widthstudio/car_project/PyBoard_PCB.xls

Comment | Description | Designator | Footprint | LibRef | Quantity
4u7 | Capacitor | C1, C7 | SMD0805 | Cap | 2
2u2 | Capacitor | C2, C13 | SMD0805 | Cap | 2
18p |  | C3, C4 | SMD0603 | Cap | 2
4u7 | Capacitor | C8, C18 | SMD0603 | Cap | 2
2.2p | Capacitor | C9, C10 | SMD0603 | Cap | 2
104 | Capacitor | C11, C12, C14, C15, C16, C17, C19,C5, C6 | SMD0603 | Cap | 7
Diode | Default Diode | D1 | SS24 - small | Diode | 1
LED RED | 红色发光二极管 | D2 | LED0603 | LED-RED | 1
LED GREEN | 绿色发光二极管 | D3 | LED0603 | LED-GREEN | 1
LED Yellow | 黄色发光二极管 | D4 | LED0603 | LED-YELLOW | 1
LED Blue | 蓝色发光二极管 | D5 | LED0603 | LED-BLUE | 1
1uH | Inductor | L1 | SMD0603 | Inductor | 1
3V3X4 | Header, 4-Pin | P1 | HDR1X4 | Header 4 | 1
5VX4 | Header, 4-Pin | P2 | HDR1X4 | Header 4 | 1
GND VIN | Header, 2-Pin | P3 | HDR1X2 | Header 2 | 1
GND TRI ECH SER 5V | Header, 5-Pin | P4 | HDR1X5 | Header 5 | 1
5V GND RX TX | Header, 4-Pin | P5 | HDR1X4 | Header 4 | 1
OUT1 OUT2 | Header, 2-Pin | P6 | HDR1X2 | Header 2 | 1
GNDX4 | Header, 4-Pin | P7 | HDR1X4 | Header 4 | 1
Header 4X2_CARLIGHTS | Header, 4-Pin, Dual row | P8 | HDR2X4 | Header 4X2 | 1
5V XJ1 XJ2 XJ3 XJ4 GND | Header, 6-Pin | P9 | HDR1X6 | Header 6 | 1
BOOT2 | Header, 2-Pin | P10 | HDR1X2 | Header 2 | 1
BOOT1 | Header, 2-Pin | P11 | HDR1X2 | Header 2 | 1
OUT3 OUT4 | Header, 2-Pin | P12 | HDR1X2 | Header 2 | 1
10K | Resistor | R1, R10, R19, R23 | SMD0603 | Res | 4
4K7 | Resistor | R2, R3, R7, R9, R11,R12,R13,R14 | SMD0603 | Res | 8
560 | Resistor | R4, R8, R20, R21, R22, R24 | SMD0603 | Res | 6
22 | Resistor | R5, R6 | SMD0603 | Res | 2
50 | Resistor | R15, R18, R16, R17 | SMD0603 | Res | 4
SW-PB | Switch | RST | SW 3X6 | SW-PB | 1
STM32F405RGT6 | ARM Cortex-M4 32-bit MCU+FPU, 210 DMIPS, 1024 kB Flash, 192 kB Internal RAM, 51 I/Os, 64-pin LQFP, -40 to 85 degC, Tray | U1 | LQFP64_M | STM32F405RGT6 | 1
XC6206 |  | U2 | SOT-23_N | XC6206 | 1
MicroUSB |  | U3 | MicroUSB | MicroUSB | 1
L298N | Dual Full Bridge Driver | U4 | Multiwatt15V | L298N | 1
USER | Switch | USR | SW 3X6 | SW-PB | 1
8M | SMD5032 8M 4Pin有源晶振 | Y1 | SMD5032 | XTAL_SMD | 1
32K | Crystal Oscillator | Y2 | TXC_9H03200019 | XTAL | 1
电池盒子
