widthstudio/car_project/project_doc/报销表格.xlsx

姓名 | 班级 | 题目 | 费用类别（器件、模块、制板或其他） | 型号 | 单价 | 个数 | 总价 | 剩余个数 | 购买链接（网上购买的需填写）
李荆晖 | 工企 | 基于Micropython的多功能小车 | 模块 | LD3320 | 76 | 1 | 76 | 0 | https://item.taobao.com/item.htm?id=525259762949&ns=1&abbucket=4 (https://item.taobao.com/item.htm?spm=a230r.1.14.83.1fda7ccdjaIbIS&id=525259762949&ns=1&abbucket=4)
陈钱牛 | 工企 | 基于Micropython的多功能小车 | 器件 | L7805ABV | 1.41 | 2 | 2.82 | 0 | https://detail.tmall.com/item.htm?id=43264897196&spm=a1z09.2.0.0.67002e8dljWcKT&_u=q2mm4h814183
陈钱牛 | 工企 | 基于Micropython的多功能小车 | 器件 | 5032 8M无源晶振 | 0.5 | 8 | 4 | 2 | https://item.taobao.com/item.htm?spm=a1z09.2.0.0.67002e8dljWcKT&id=577059124463&_u=q2mm4h8151b2
陈钱牛 | 工企 | 基于Micropython的多功能小车 | 器件 | STM32RGT6 | 18.3 | 6 | 109.8 | 0 | https://item.taobao.com/item.htm?spm=a1z09.2.0.0.67002e8dljWcKT&id=593075165051&_u=q2mm4h816ff9
陈钱牛 | 工企 | 基于Micropython的多功能小车 | 器件 | L298N | 8.08 | 2 | 16.16 | 0 | https://detail.tmall.com/item.htm?id=12993617140&spm=a1z09.2.0.0.67002e8dljWcKT&_u=q2mm4h813b0e
陈钱牛 | 工企 | 基于Micropython的多功能小车 | 器件 | 32K晶振 | 0.57 | 4 | 2.28 | 0 | https://item.taobao.com/item.htm?spm=a1z09.2.0.0.67002e8dljWcKT&id=572487260654&_u=q2mm4h81398c
陈钱牛 | 工企 | 基于Micropython的多功能小车 | 器件 | USB母头 | 0.304 | 10 | 3.04 | 0 | https://detail.tmall.com/item.htm?id=14422856956&spm=a1z09.2.0.0.67002e8dljWcKT&_u=q2mm4h814bf0
陈钱牛 | 工企 | 基于Micropython的多功能小车 | 器件 | 绿色贴片LED | 0.1715 | 20 | 3.43 | 0 | https://detail.tmall.com/item.htm?id=13860351935&spm=a1z09.2.0.0.67002e8dljWcKT&_u=q2mm4h814348
陈钱牛 | 工企 | 基于Micropython的多功能小车 | 器件 | 红色贴片LED | 0.0324 | 50 | 1.62 | 0 | https://detail.tmall.com/item.htm?id=13860351935&spm=a1z09.2.0.0.67002e8dljWcKT&_u=q2mm4h814348
陈钱牛 | 工企 | 基于Micropython的多功能小车 | 器件 | 黄色贴片LED | 0.1735 | 20 | 3.47 | 0 | https://detail.tmall.com/item.htm?id=13860351935&spm=a1z09.2.0.0.67002e8dljWcKT&_u=q2mm4h814348
陈钱牛 | 工企 | 基于Micropython的多功能小车 | 器件 | 蓝色贴片LED | 0.1385 | 20 | 2.77 | 0 | https://detail.tmall.com/item.htm?id=13860351935&spm=a1z09.2.0.0.67002e8dljWcKT&_u=q2mm4h814348
陈钱牛 | 工企 | 基于Micropython的多功能小车 | 器件 | 0603 1uH电感 | 0.058 | 20 | 1.16 | 0 | https://detail.tmall.com/item.htm?id=13673263456&spm=a1z09.2.0.0.67002e8dljWcKT&_u=q2mm4h8105ce
陈钱牛 | 工企 | 基于Micropython的多功能小车 | 器件 | XC6206稳压芯片 | 0.185 | 10 | 1.85 | 0 | https://detail.tmall.com/item.htm?id=14477500122&spm=a1z09.2.0.0.67002e8dljWcKT&_u=q2mm4h8107e8
陈钱牛 | 工企 | 基于Micropython的多功能小车 | 器件 | 开关按钮（绿色无光） | 1.28 | 1 | 1.28 | 0 | https://detail.tmall.com/item.htm?id=585191757505&spm=a1z09.2.0.0.67002e8dljWcKT&_u=q2mm4h818958
陈钱牛 | 工企 | 基于Micropython的多功能小车 | 模块 | HC-SR04 | 6.77 | 2 | 13.54 | 0 | https://detail.tmall.com/item.htm?id=580427945752&spm=a1z09.2.0.0.67002e8dljWcKT&_u=q2mm4h819abf
陈钱牛 | 工企 | 基于Micropython的多功能小车 | 模块 | 码盘计数器 | 5.53 | 2 | 11.06 | 2 | https://detail.tmall.com/item.htm?id=564149772805&spm=a1z09.2.0.0.67002e8dljWcKT&_u=q2mm4h81c4b5
陈钱牛 | 工企 | 基于Micropython的多功能小车 | 模块 | LM2596S 稳压器 | 19.06 | 1 | 19.06 | 1 | https://detail.tmall.com/item.htm?id=41307963557&spm=a1z09.2.0.0.67002e8dljWcKT&_u=q2mm4h81f88c
陈钱牛 | 工企 | 基于Micropython的多功能小车 | 模块 | L298N | 5.83 | 2 | 11.66 | 2 | https://item.taobao.com/item.htm?spm=a1z09.2.0.0.67002e8dljWcKT&id=15751837530&_u=q2mm4h819cb8
陈钱牛 | 工企 | 基于Micropython的多功能小车 | 模块 | 红外管模块 | 1.33 | 2 | 2.66 | 2 | https://item.taobao.com/item.htm?spm=a1z09.2.0.0.67002e8dljWcKT&id=581721553384&_u=q2mm4h812bb5
陈钱牛 | 工企 | 基于Micropython的多功能小车 | 模块 | USB转TTL模块 | 8.3 | 1 | 8.3 | 1 | https://detail.tmall.com/item.htm?id=26521552017&spm=a1z09.2.0.0.67002e8dljWcKT&_u=q2mm4h813421
陈钱牛 | 工企 | 基于Micropython的多功能小车 | 模块 | HC06蓝牙模块 | 21 | 1 | 21 | 0 | https://item.taobao.com/item.htm?spm=a1z09.2.0.0.67002e8dljWcKT&id=543489102902&_u=q2mm4h81cb55
陈钱牛 | 工企 | 基于Micropython的多功能小车 | 模块 | HC02蓝牙模块 | 17.8 | 1 | 17.8 | 0 | https://item.taobao.com/item.htm?spm=a1z09.2.0.0.67002e8dljWcKT&id=543489102902&_u=q2mm4h81cb56
陈钱牛 | 工企 | 基于Micropython的多功能小车 | 其他 | 舵机云台 | 18.8 | 1 | 18.8 | 0 | https://detail.tmall.com/item.htm?id=567021295563&spm=a1z09.2.0.0.67002e8dljWcKT&_u=q2mm4h81fd46
陈钱牛 | 工企 | 基于Micropython的多功能小车 | 其他 | 大容量8.4V锂电池 | 42 | 1 | 42 | 0 | https://item.taobao.com/item.htm?spm=a1z09.2.0.0.67002e8dljWcKT&id=531990145742&_u=q2mm4h81090e
陈钱牛 | 工企 | 基于Micropython的多功能小车 | 其他 | 锂电池充电器 | 10.8 | 1 | 10.8 | 1 | https://item.taobao.com/item.htm?spm=a1z09.2.0.0.67002e8dljWcKT&id=546489778669&_u=q2mm4h81f00a
陈钱牛 | 工企 | 基于Micropython的多功能小车 | 其他 | 锂电池充电转接头 | 1.5 | 1 | 1.5 | 1 | https://item.taobao.com/item.htm?spm=a1z09.2.0.0.67002e8dljWcKT&id=568056529789&_u=q2mm4h81222e
陈钱牛 | 工企 | 基于Micropython的多功能小车 | 其他 | 小车底盘 | 29.68 | 1 | 29.68 | 0 | https://item.taobao.com/item.htm?spm=a1z09.2.0.0.67002e8dljWcKT&id=41398682326&_u=q2mm4h81c2e1
陈钱牛 | 工企 | 基于Micropython的多功能小车 | 其他 | 40P公对公连接线 | 2.6 | 1 | 2.6 | 0 | https://item.taobao.com/item.htm?spm=a1z09.2.0.0.67002e8dljWcKT&id=544521868669&_u=q2mm4h81927d
陈钱牛 | 工企 | 基于Micropython的多功能小车 | 其他 | 面包板 | 4.5 | 1 | 4.5 | 1 | https://item.taobao.com/item.htm?spm=a1z09.2.0.0.67002e8dljWcKT&id=543472797890&_u=q2mm4h81b7f7
陈钱牛 | 工企 | 基于Micropython的多功能小车 | 其他 | 电池盒子 | 1.62 | 1 | 1.62 | 1 | https://item.taobao.com/item.htm?spm=a1z09.2.0.0.67002e8dljWcKT&id=543472797890&_u=q2mm4h81b7f7
总计 |  |  |  |  |  |  | 446.26
