widthstudio/car_project/PCB3/PyBoard_PCB.pdf

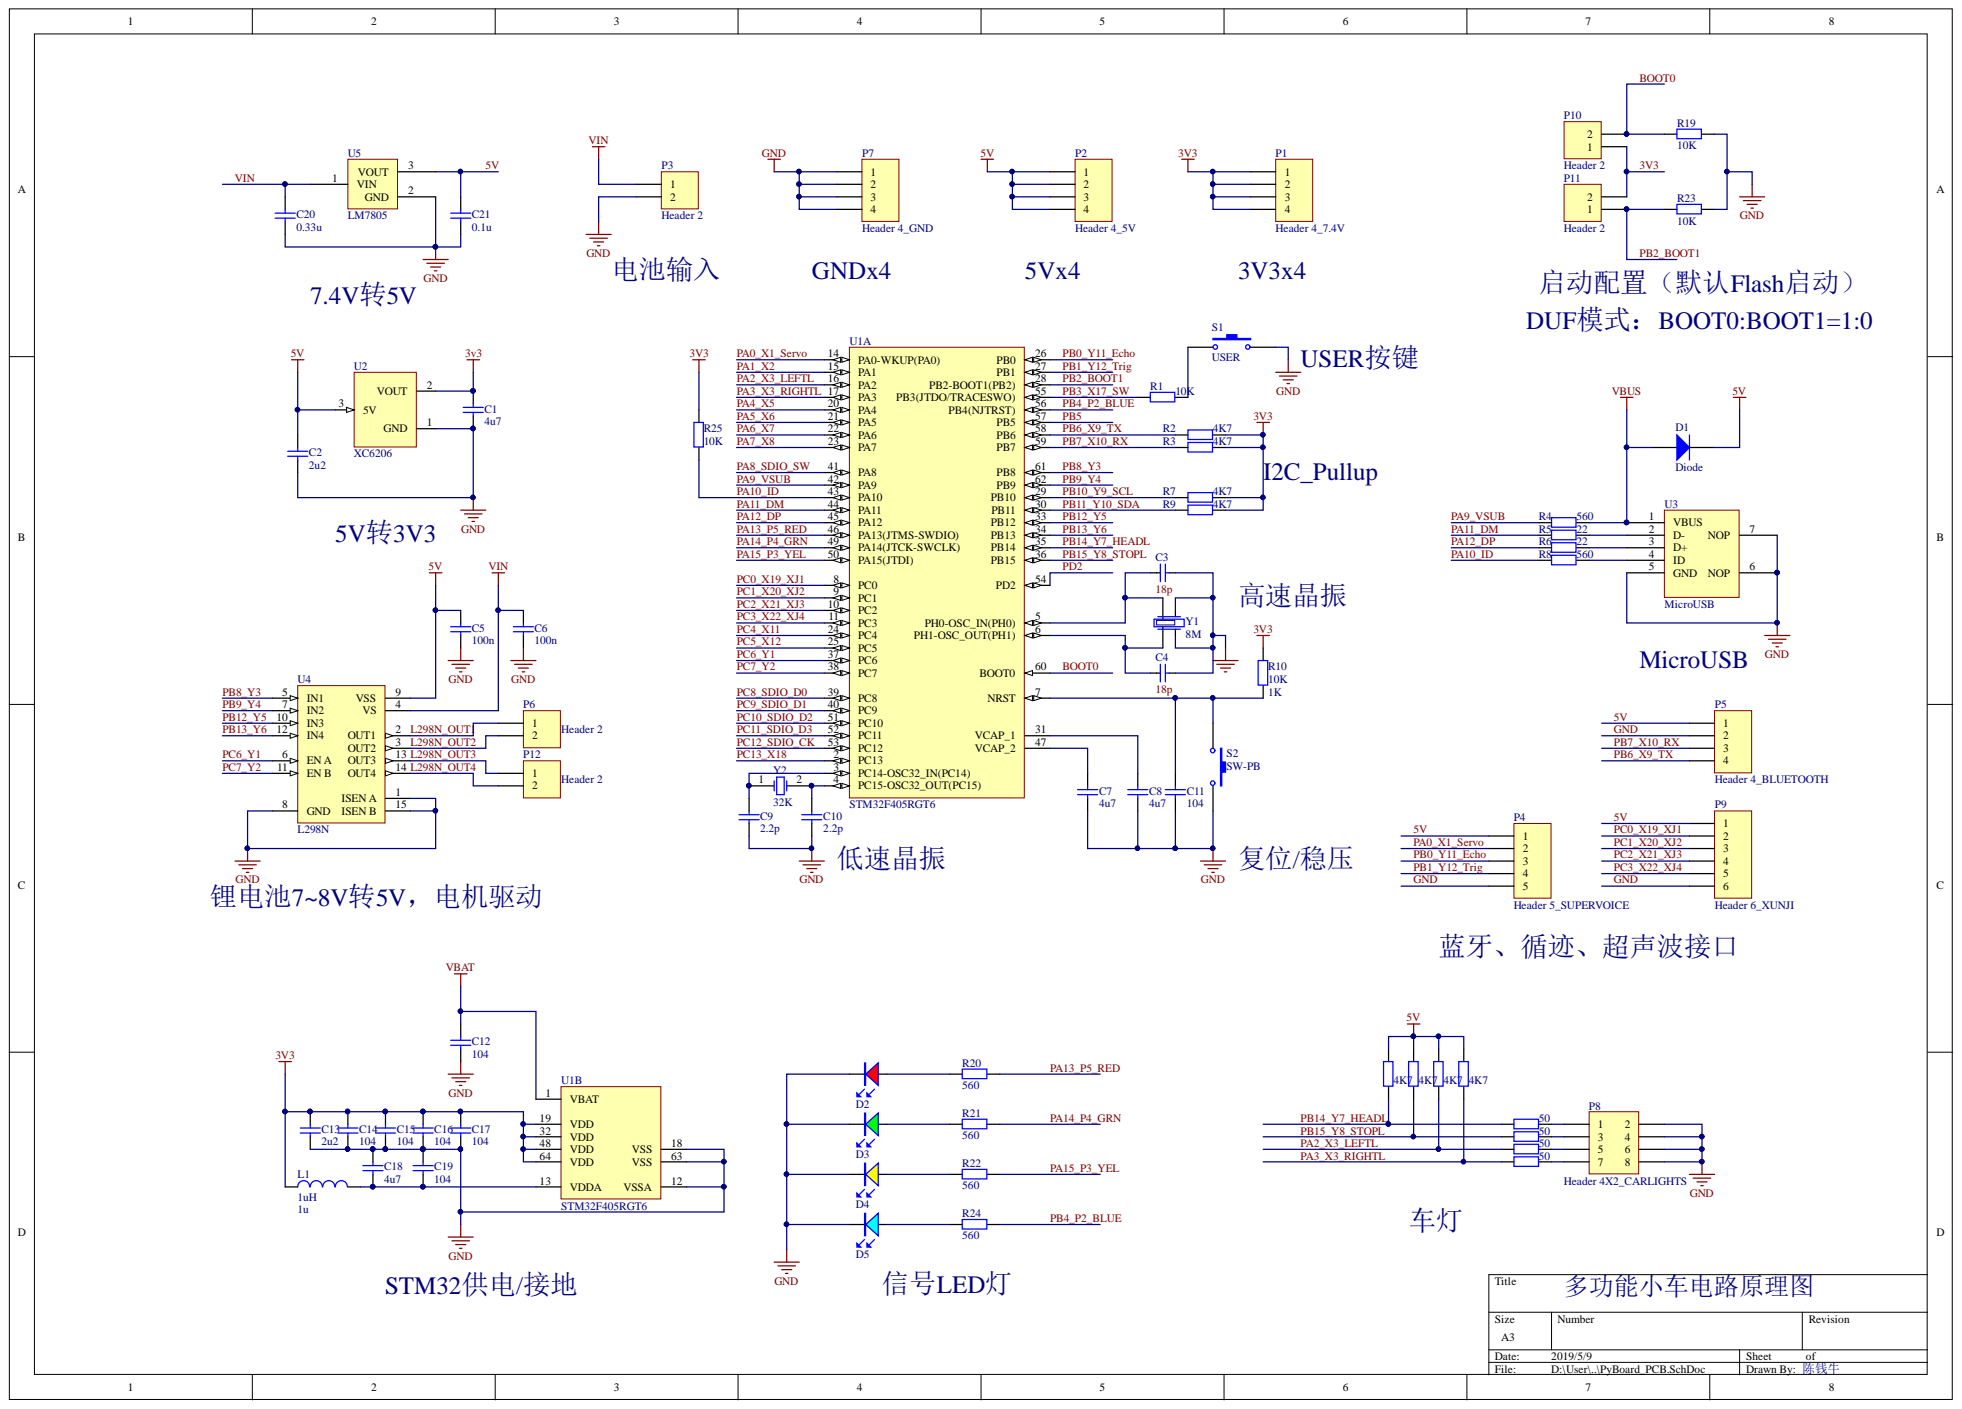
[picture p56: page 1]
