widthstudio/car_project/(list of files, drawings)

Other design files:
PCB2/My_Micropython1/Miscellaneous Devices.PcbLib
PCB2/My_Micropython1/My_Micropython.SCHLIB
PCB2/My_Micropython1/PyBoard_PCB1.PcbLib
PCB2/My_Micropython1/PyBoard_PCB.PcbLib
PCB2/My_Micropython.PrjPCB
PCB2/My_Micropython/My_Micropython.SCHLIB
PCB2/My_Micropython/PyBoard_PCB.PcbLib
PCB2/My_Pyboard1/My_Pyboard.SCHLIB
PCB2/My_Pyboard1/PyBoard_PCB.PcbLib
PCB2/My_Pyboard/PyBoard_PCB.PcbLib
PCB2/PyBoard_PCB.PcbDoc
PCB2/PyBoard_PCB.PcbLib
PCB2/PyBoard_PCB.SchDoc
PCB3/PCB3.PrjPCB
PCB3/PCB31/Miscellaneous Devices.PcbLib
PCB3/PCB31/PCB3.SCHLIB
PCB3/PCB31/PyBoard_PCB.PcbLib
PCB3/PyBoard_PCB.PcbDoc
PCB3/PyBoard_PCB.SchDoc
PCB/My_Pyboard.PrjPCB
PCB/PyBoard_PCB.PcbDoc
PCB/PyBoard_PCB.SchDoc
