widthstudio/car_project/(commit log)

2019-03-08 测试完成，明天组装小车
2019-03-09 一次封装完成，等待将每一个类单独封装
2019-03-09 小车驱动、灯封装完成，一小时后去工程坊
2019-03-17 超声波封装完成，但是超声波模块坏了
2019-03-18 日志更新 3新 3_18
2019-03-20 超声波没问题，引脚错了，已改正
2019-03-20 “上上传计划书
2019-03-20 小车运动、蓝牙、避障都已经实现，正在学习制板，所有文件都上传
    [PyBoard_PCB.PcbDoc, PyBoard_PCB.SchDoc, STM32.PcbLib, STM32.SchLib]
2019-03-20 PCB最小系统原理图绘制，封装基本匹配好
    [My_Pyboard.PrjPCB, PyBoard_PCB.PcbDoc, PyBoard_PCB.SchDoc, STM32.PcbLib, STM32.SchLib]
2019-03-21 3_21改
    [My_Pyboard.PrjPCB, PyBoard_PCB.PcbDoc, PyBoard_PCB.SchDoc, STM32.PcbLib, STM32.SchLib]
2019-03-23 3_23 更新PCB
    [My_Pyboard.PrjPCB, PyBoard_PCB.PcbDoc, PyBoard_PCB.SchDoc, STM32.PcbLib, STM32.SchLib]
2019-03-23 33_23更新日志
2019-03-24 3_24 PCB更新新，基本完成
    [My_Pyboard.PrjPCB, PyBoard_PCB.PcbDoc, PyBoard_PCB.SchDoc, STM32.PcbLib, STM32.SchLib]
2019-03-24 3_24 pcb
    [My_Pyboard.PrjPCB, STM32.PcbLib, STM32.SchLib]
2019-03-30 MultifCar 没有连接小车调试完成
    [My_Pyboard.PrjPCB, My_Pyboard.SCHLIB, PyBoard_PCB.PcbDoc, PyBoard_PCB.PcbLib, STM32.PcbLib, STM32.SchLib]
2019-03-30 PCB2 3_30
    [My_Micropython.PrjPCB, My_Pyboard.SCHLIB, PyBoard_PCB.PcbDoc, PyBoard_PCB.PcbLib, PyBoard_PCB.SchDoc, STM32.PcbLib, STM32.SchLib, 引脚分配.xlsx]
2019-03-31 PCB2还差一点
    [My_Micropython.PrjPCB, My_Micropython.SCHLIB, My_Pyboard.SCHLIB, PyBoard_PCB.PcbDoc, PyBoard_PCB.PcbLib, PyBoard_PCB.SchDoc, STM32.PcbLib, STM32.SchLib]
2019-03-31 PCB2 finished
    [PyBoard_PCB.PcbDoc]
2019-04-03 4_3电设课上，实际调试成功
    [My_Pyboard.SCHLIB, PyBoard_PCB.PcbLib]
2019-04-06 4_3电设课上，实际调试成功
    # Conflicts:
    # PCB2/PyBoard_PCB.SchDocPreviews
2019-04-06 4_6 PCB第三版制作完成
    [My_Micropython.PrjPCB, My_Micropython.SCHLIB, PyBoard_PCB.PcbDoc, PyBoard_PCB.PcbLib, PyBoard_PCB.SchDoc]
2019-04-09 所有功能完成
2019-04-09 功能全部完成
    [PyBoard_PCB.PcbDoc]
2019-04-10 PCB调整,油印，程序调整
    [PyBoard_PCB.PcbDoc, PyBoard_PCB.SchDoc, PyBoard_PCB.xls]
2019-04-10 采购好了
    [PyBoard_PCB.PcbDoc, PyBoard_PCB.xls]
2019-05-03 5.3日暂存
    [My_Micropython.PrjPCB, PyBoard_PCB.PcbDoc, PyBoard_PCB.PcbLib, PyBoard_PCB.SchDoc]
2019-05-08 PCB3 finished
    [Miscellaneous Devices.PcbLib, My_Pyboard.SCHLIB, PCB3.PrjPCB, PCB3.SCHLIB, PyBoard_PCB.PcbDoc, PyBoard_PCB.PcbLib, PyBoard_PCB.SchDoc]
2019-05-09 5.9 周四
    [PyBoard_PCB.SchDoc]
2019-05-24 板子做完以后调试的版本
2019-05-24 5月24日整合
